leardilap/clasicOverdrive/README.md

# 3D view

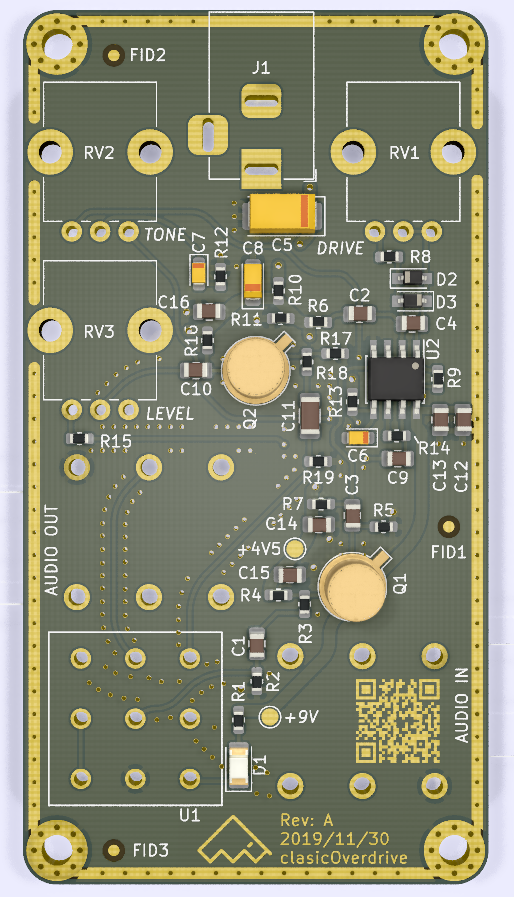
[picture p1: images/3D_top.png]
3D top


# Order Online

https://aisler.net/p/NZXUXPBU
