leardilap/clasicOverdrive/images/clasicOverdrive_QR.png

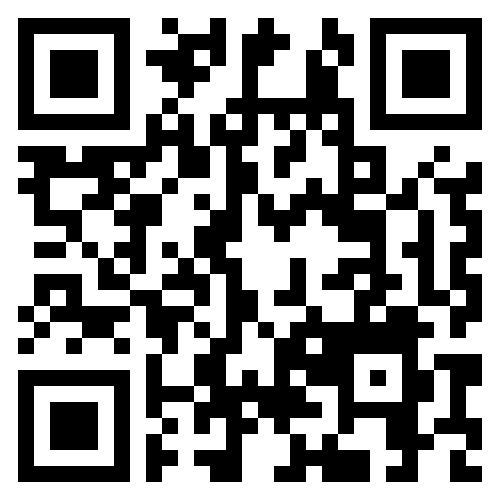
images/clasicOverdrive_QR.png
