leardilap/clasicOverdrive/pdf/clasicOverdrive.pdf

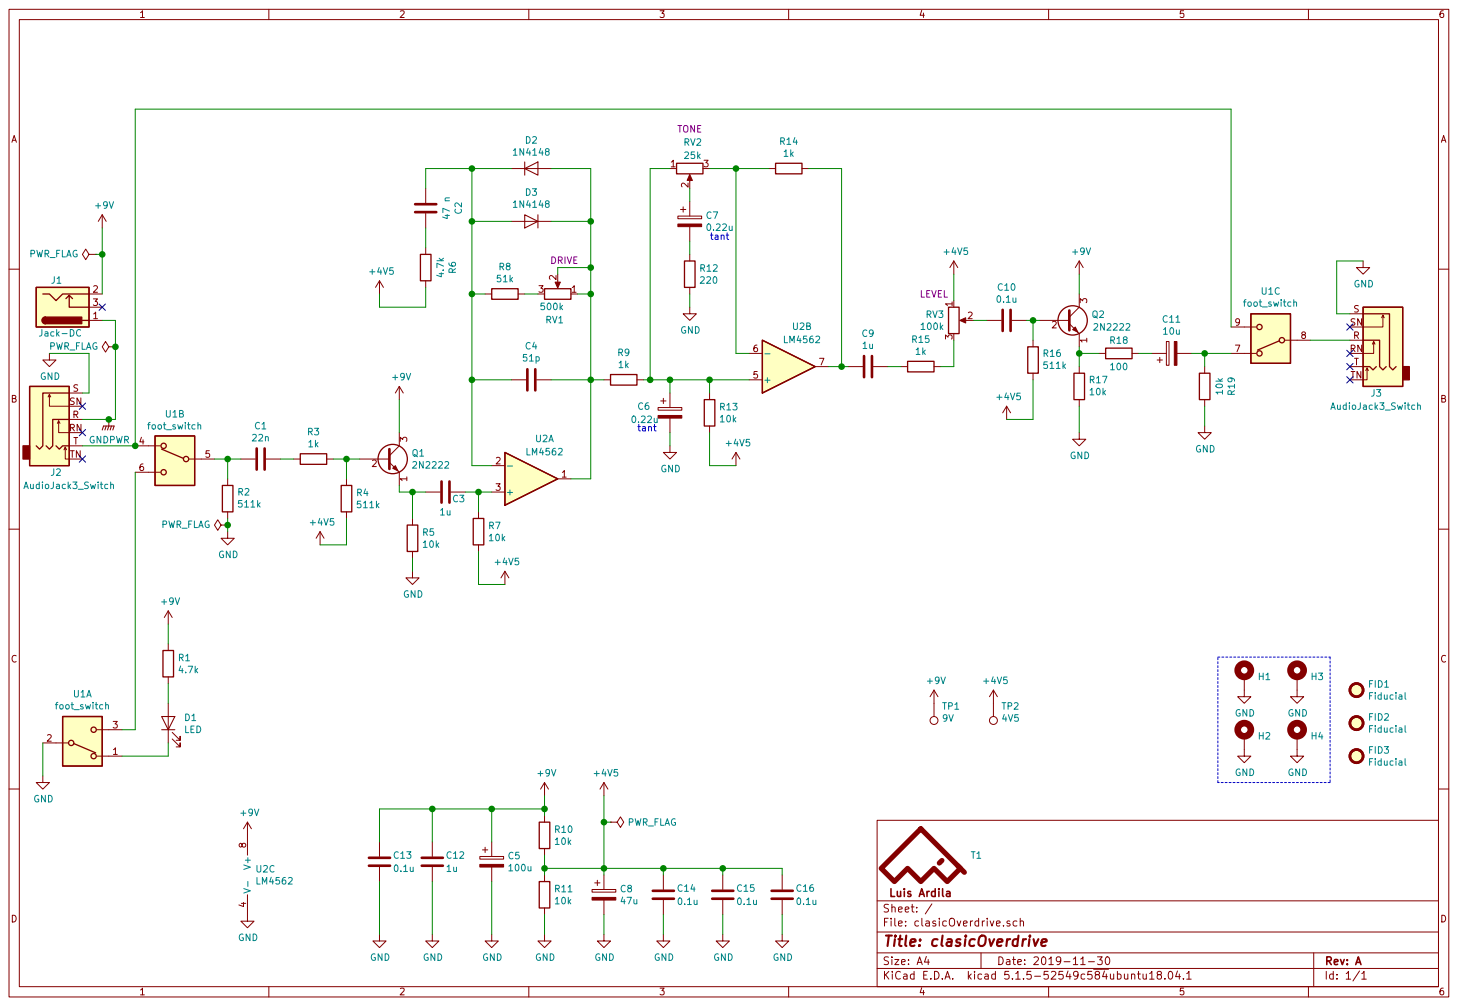
[picture p3: page 1]

Luis Ardila
File: clasicOverdrive.sch Sheet: /
Id: 1/1 Title: clasicOverdrive
