leardilap/clasicOverdrive/pdf/clasicOverdrive_pcb.pdf

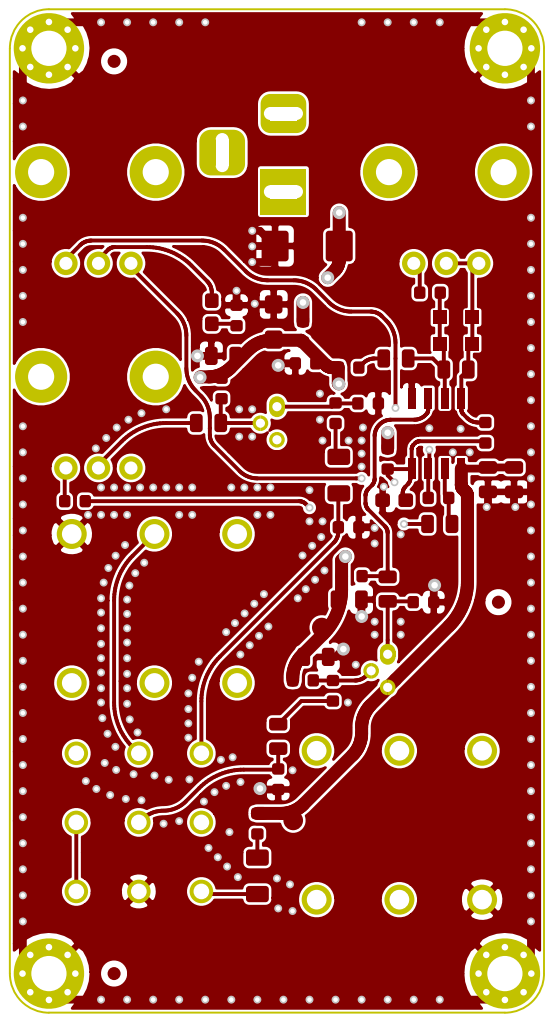
[picture p4: page 1]

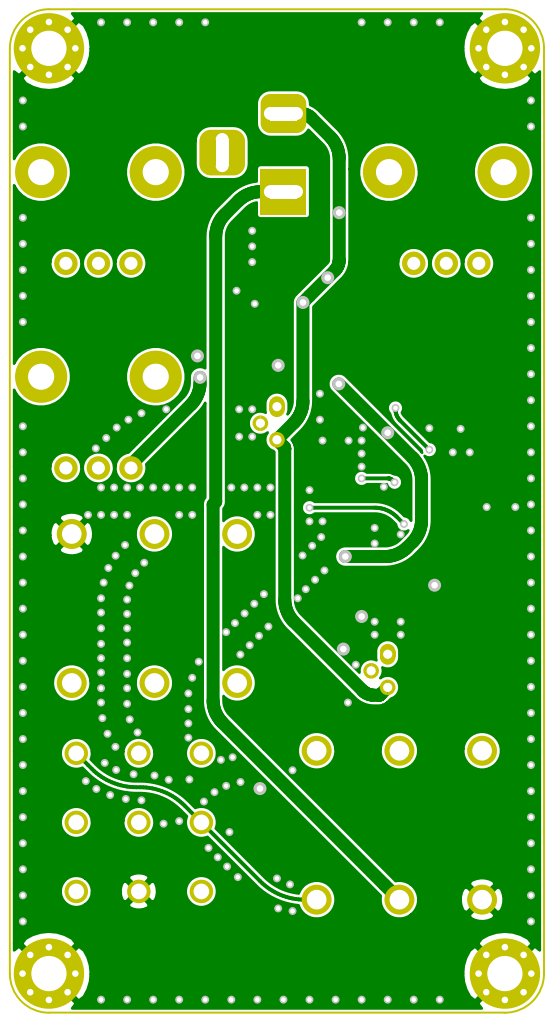
[picture p5: page 2]

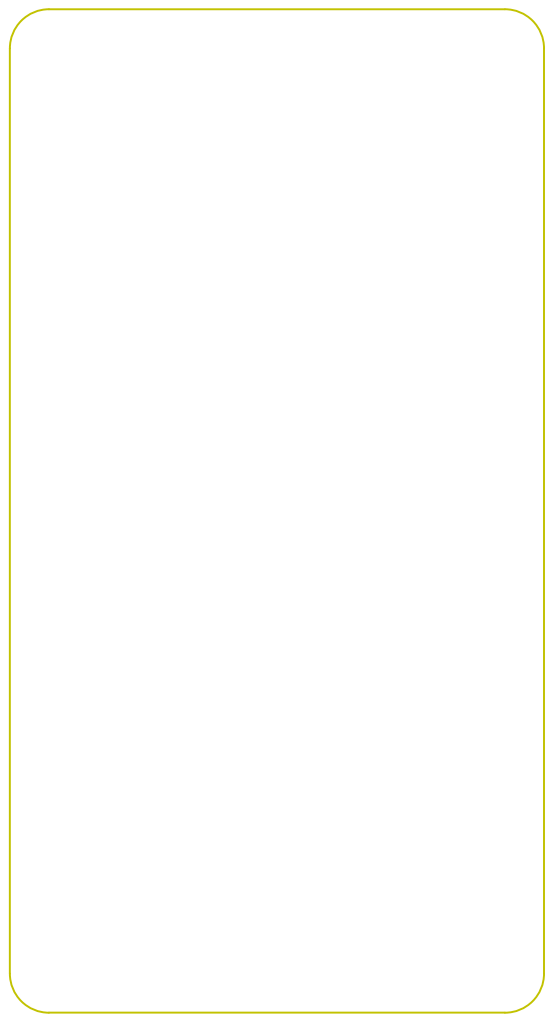
[picture p6: page 3]

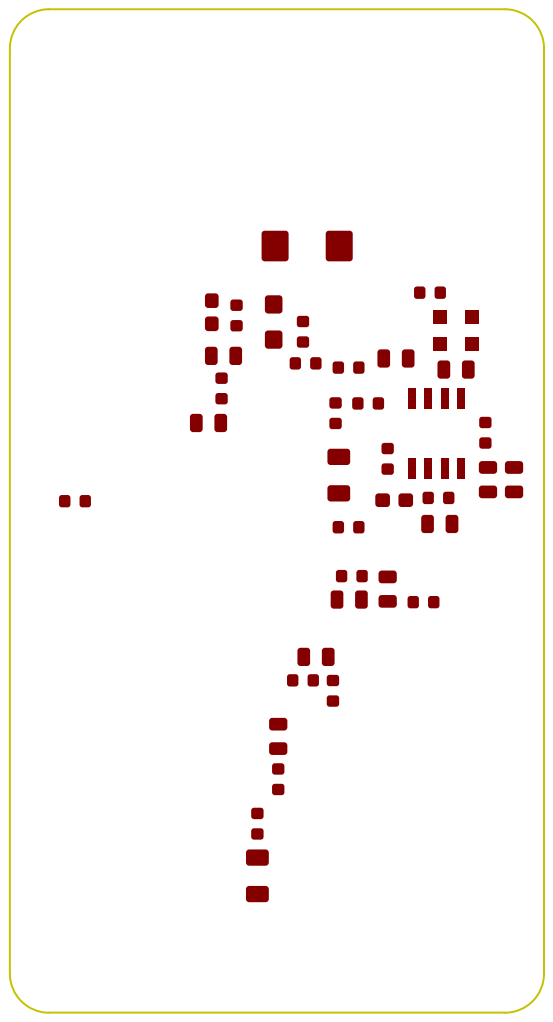
[picture p7: page 5]

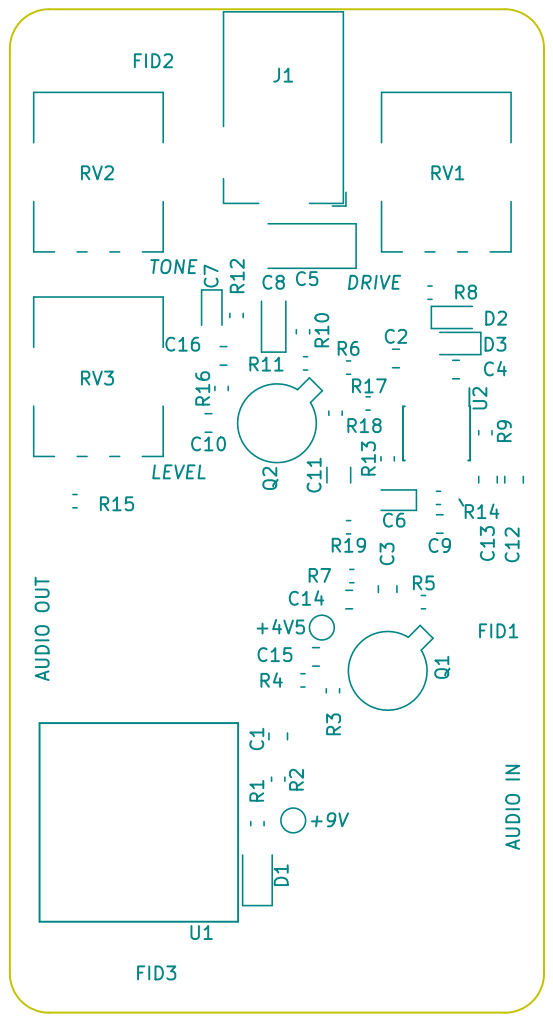
[picture p8: page 7]

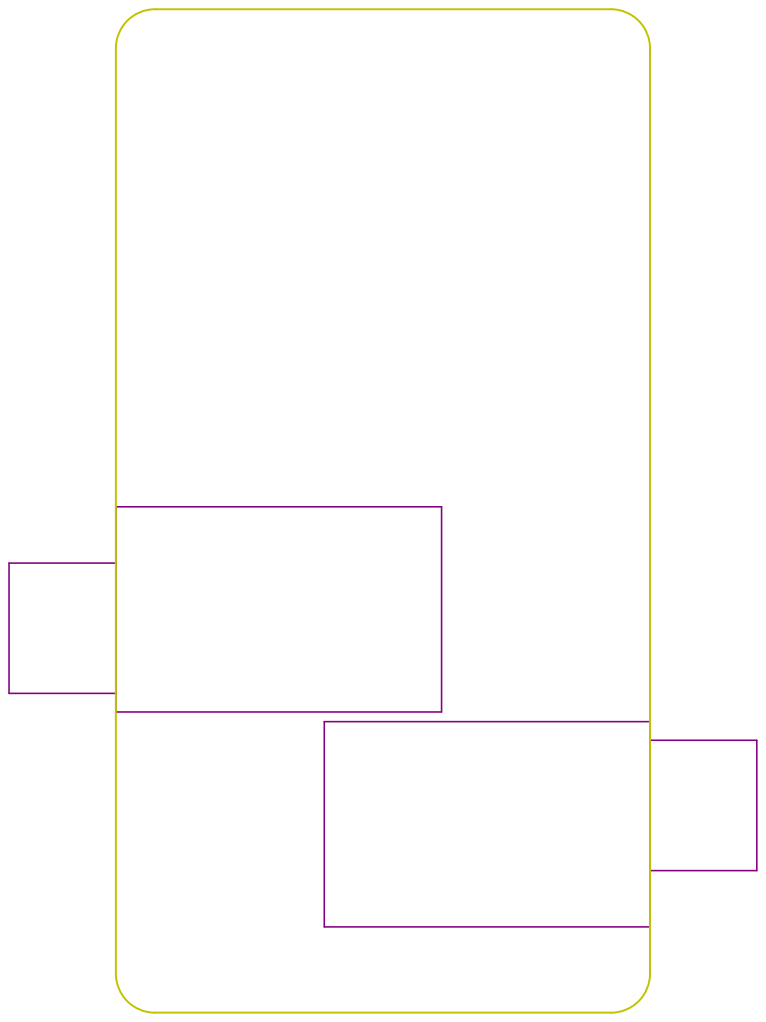
[picture p9: page 8]

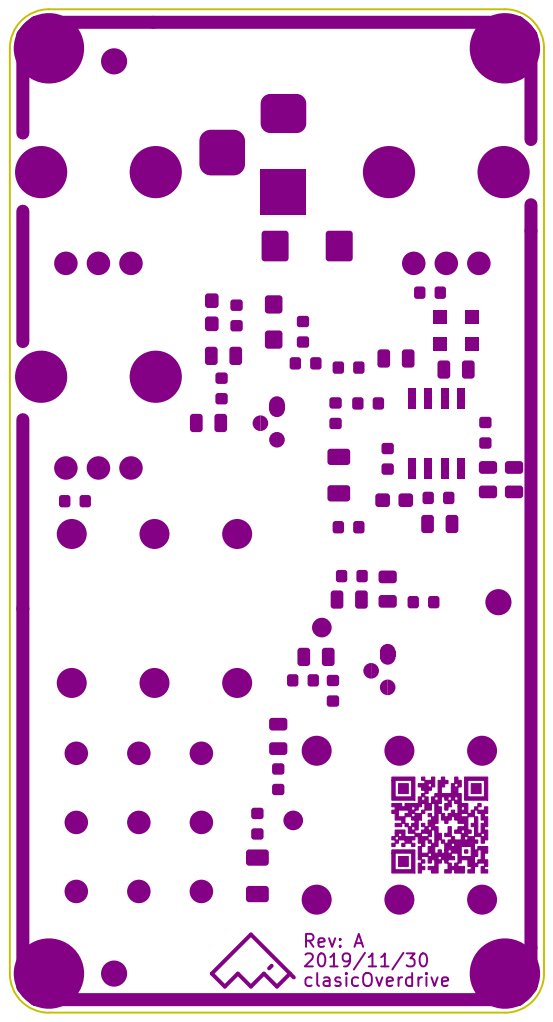
[picture p10: page 9]

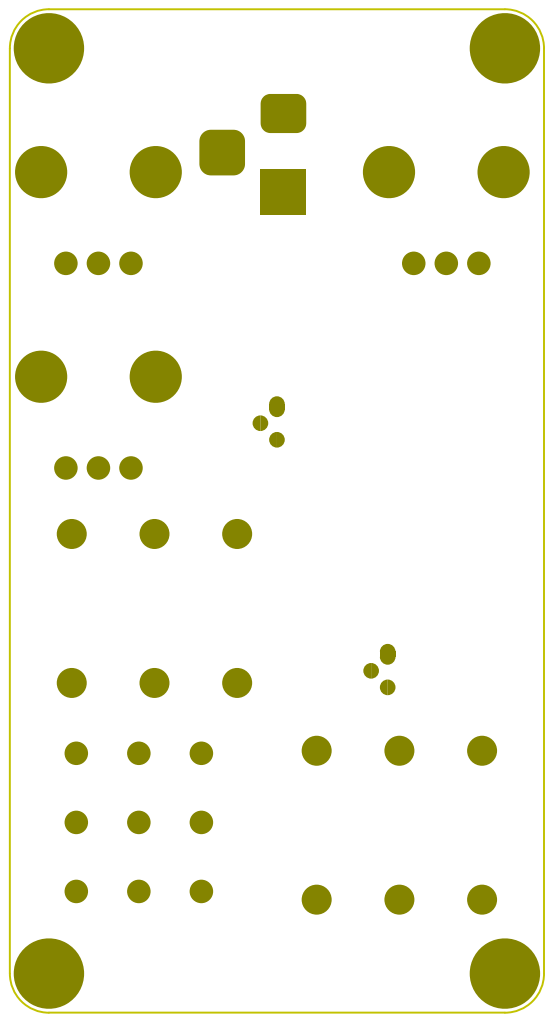
[picture p11: page 10]

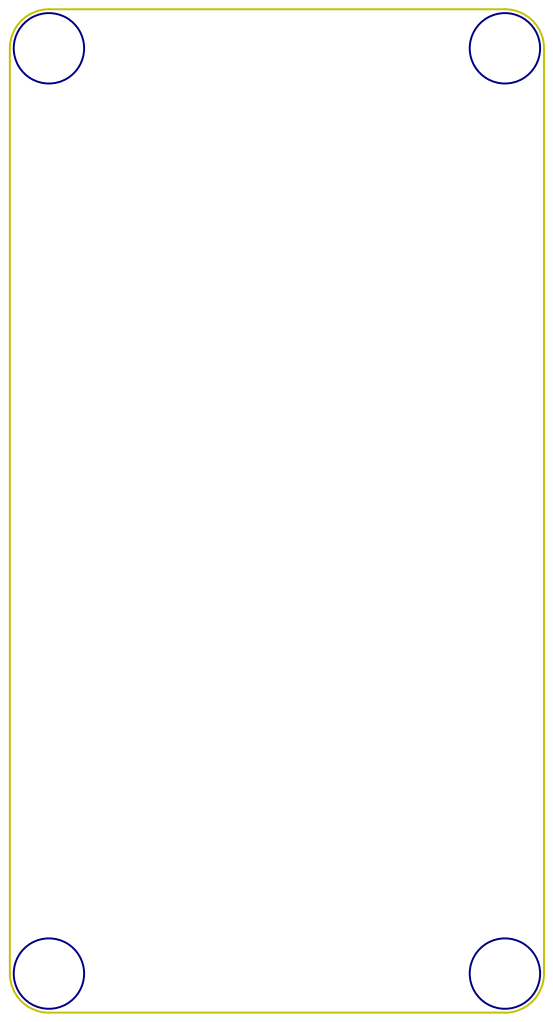
[picture p12: page 12]

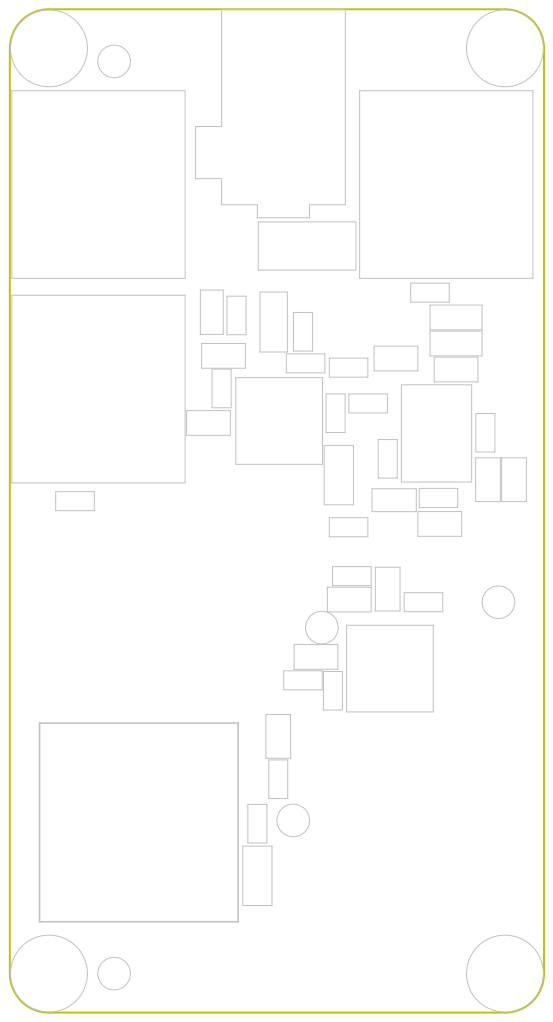
[picture p13: page 17]

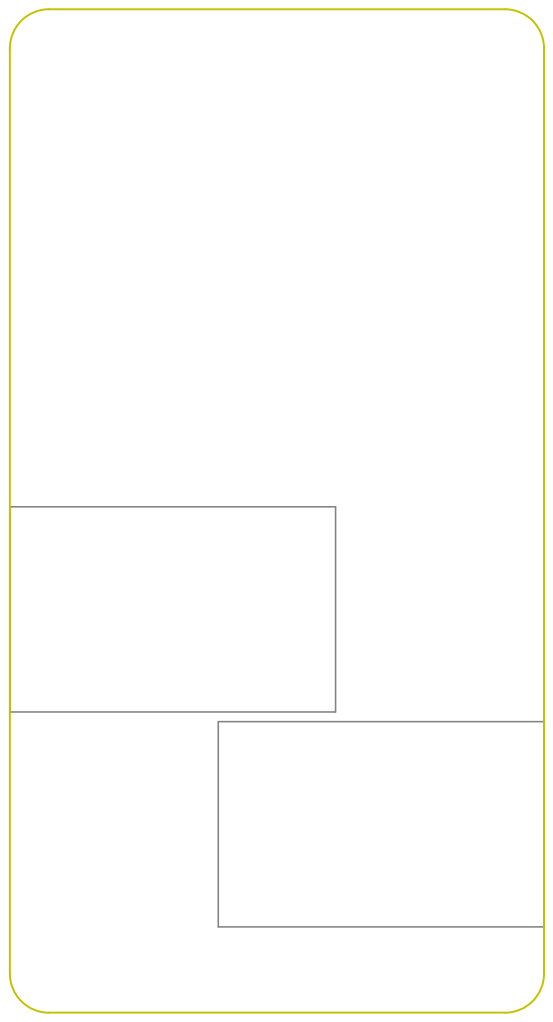
[picture p14: page 18]

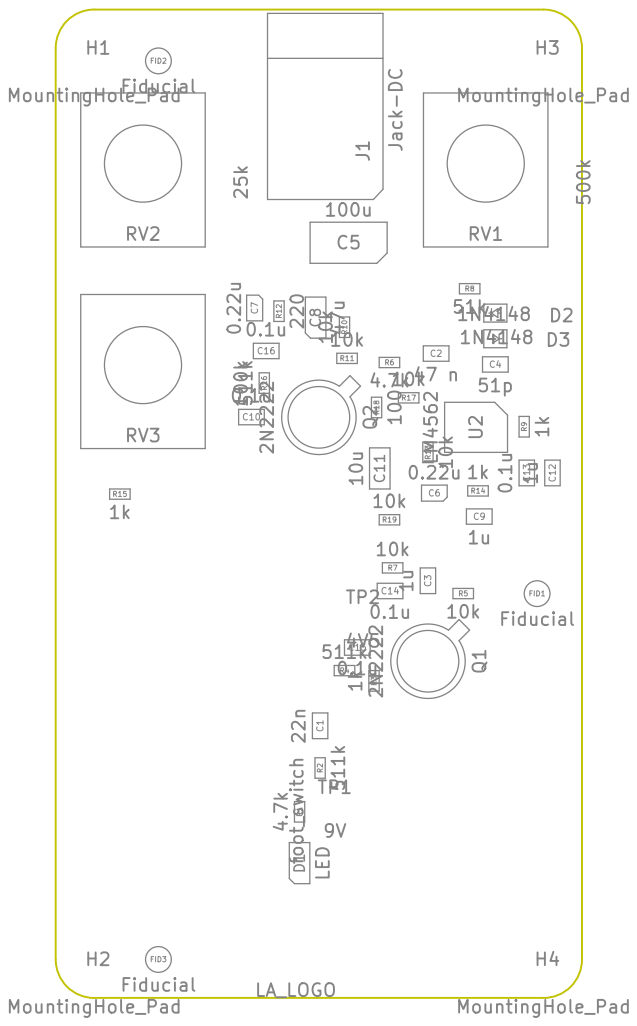
[picture p15: page 19]

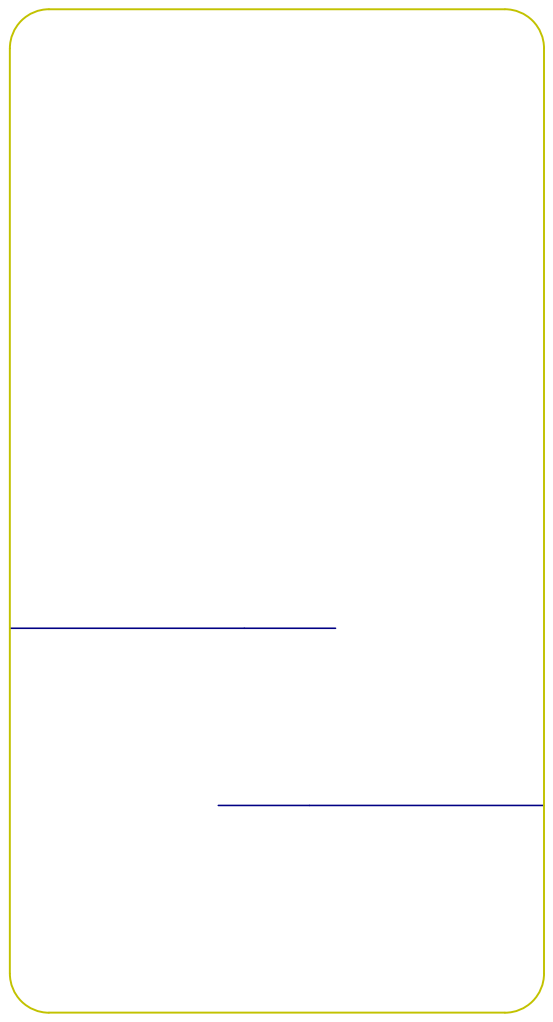
[picture p16: page 20]
