leardilap/clasicOverdrive/clasicOverdrive.kicad_pcb

## KiCad design clasicOverdrive.kicad_pcb (2019-12-09)

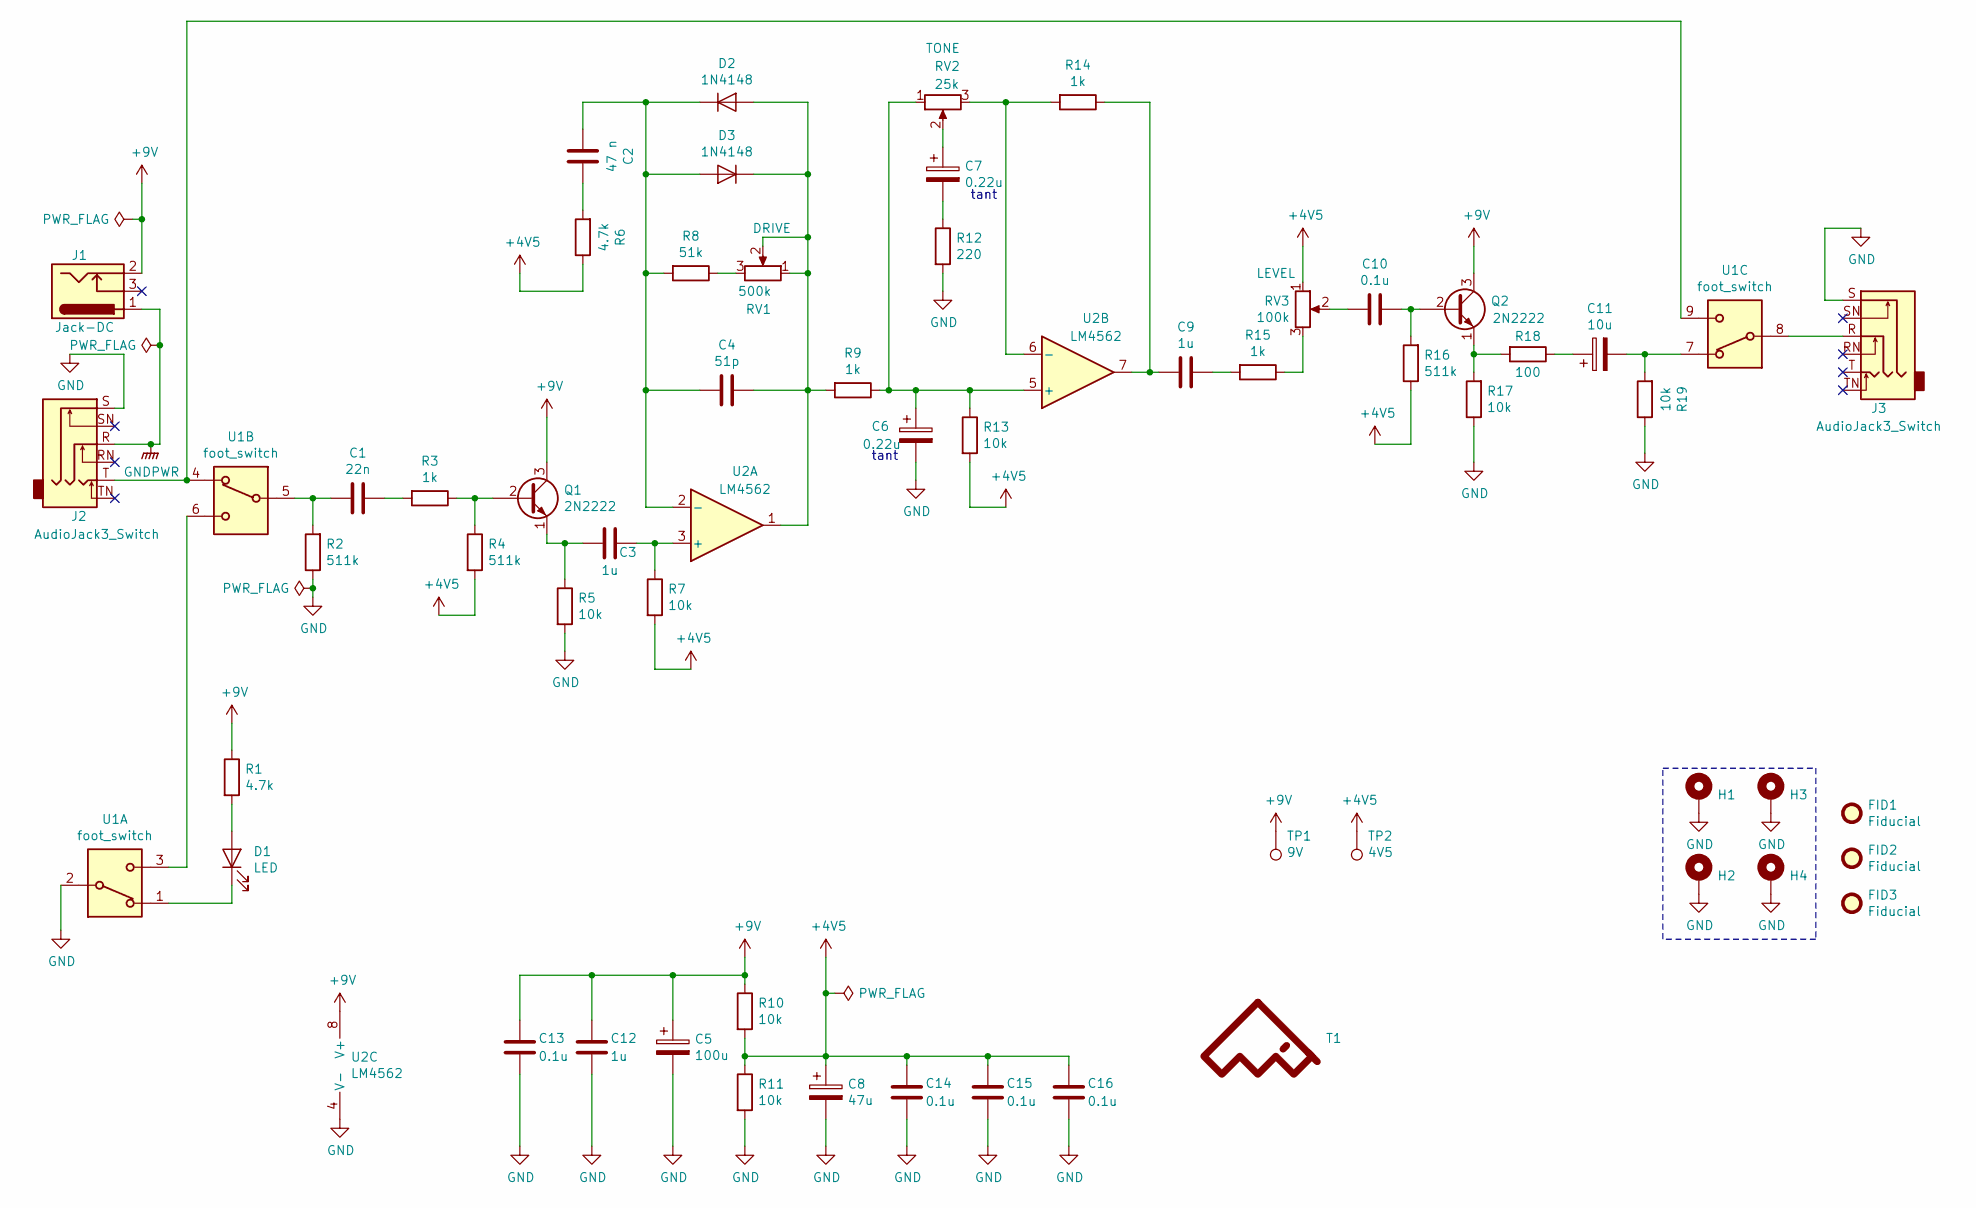
[picture p17: schematic clasicOverdrive.sch]

Parts:
C1: 22n; C_0805_2012Metric; Digi-Key 399-1163-1-ND
C2: 47 n; C_0805_2012Metric; Digi-Key 1276-2527-1-ND
C3, C9, C12: 1u; C_0805_2012Metric; Digi-Key 1276-6471-1-ND
C4: 51p; C_0805_2012Metric; Digi-Key 1276-2670-1-ND
C5: 100u; CP_EIA-6032-28_Kemet-C; Digi-Key 399-11392-1-ND
C6, C7: 0.22u; CP_EIA-2012-12_Kemet-R; Digi-Key 718-2502-1-ND
C8: 47u; CP_EIA-3216-18_Kemet-A; Digi-Key 718-2387-1-ND
C10, C13, C14, C15, C16: 0.1u; C_0805_2012Metric; Digi-Key 399-8000-1-ND
C11: 10u; C_1206_3216Metric; Digi-Key 478-10743-1-ND
D1: LED; LED_1206_3216Metric; Digi-Key 732-4989-1-ND
D2, D3: 1N4148; D_SOD-323_HandSoldering; Digi-Key 1N4148WXTPMSCT-ND
FID1, FID2, FID3: Fiducial; Fiducial_1mm_Mask2mm
H1, H2, H3, H4: MountingHole_Pad; MountingHole_2.7mm_M2.5_Pad_Via
J1: Jack-DC; BarrelJack_Horizontal; Digi-Key CP-002A-ND
J2, J3: AudioJack3_Switch; Jack_6.35mm_Amphenol_ACJS-MHOM; Digi-Key 889-1818-ND
Q1, Q2: 2N2222; TO-18-3; Digi-Key 1514-2N2222APBFREE-ND
R1, R6: 4.7k; R_0603_1608Metric; Digi-Key 311-4.70KHRCT-ND
R2, R4, R16: 511k; R_0603_1608Metric; Digi-Key 311-511KHRCT-ND
R3, R9, R14, R15: 1k; R_0603_1608Metric; Digi-Key 311-1.00KHRCT-ND
R5, R7, R10, R11, R13, R17, R19: 10k; R_0603_1608Metric; Digi-Key 311-10.0KHRCT-ND
R8: 51k; R_0603_1608Metric; Digi-Key YAG3616CT-ND
R12: 220; R_0603_1608Metric; Digi-Key 311-220HRCT-ND
R18: 100; R_0603_1608Metric; Digi-Key 311-100HRCT-ND
RV1: 500k; Potentiometer_Bourns_PTV09A-1_Single_Vertical; Digi-Key PTV09A-4020F-A504-ND
RV2: 25k; Potentiometer_Bourns_PTV09A-1_Single_Vertical; Digi-Key PTV09A-4020F-B203-ND
RV3: 100k; Potentiometer_Bourns_PTV09A-1_Single_Vertical; Digi-Key PTV09A-4020F-B104-ND
T1: LA_LOGO; LA_LOGO_MASK
TP1: 9V; TestPoint_Pad_D1.5mm
TP2: 4V5; TestPoint_Pad_D1.5mm
U1: foot_switch; Foot_Switch_E-Switch_FS57003PLT2B2M2QE; Digi-Key EG5492-ND
U2: LM4562; SOIC-8_3.9x4.9mm_P1.27mm; Digi-Key 296-35279-1-ND

Connections:
+4V5: C8.1, C14.1, C15.1, C16.1, R4.2, R6.1, R7.2, R10.2, R11.1, R13.2, R16.1, RV3.1, TP2.1
+9V: C5.1, C12.1, C13.1, J1.2, Q1.3 (C), Q2.3 (C), R1.1, R10.1, TP1.1, U2.8 (V+)
GND: C5.2, C6.2, C8.2, C12.2, C13.2, C14.2, C15.2, C16.2, H1.1, H2.1, H3.1, H4.1, J2.S, J3.S, R2.1, R5.2, R11.2, R12.2, R17.1, R19.1, U1.2, U2.4 (V-)
GNDPWR: J1.1, J2.R
unnamed: C1.1, R3.2
unnamed: C1.2, R2.2, U1.5
unnamed: C2.1, R6.2
unnamed: C2.2, C4.1, D2.1 (K), D3.2 (A), R8.2, U2.2 (-)
unnamed: C3.1, R7.1, U2.3 (+)
unnamed: C3.2, Q1.1 (E), R5.1
unnamed: C4.2, D2.2 (A), D3.1 (K), R9.2, RV1.1, RV1.2, U2.1
unnamed: C6.1, R9.1, R13.1, RV2.1, U2.5 (+)
unnamed: C7.1, RV2.2
unnamed: C7.2, R12.1
unnamed: C9.1, R15.2
unnamed: C9.2, R14.1, U2.7
unnamed: C10.1, Q2.2 (B), R16.2
unnamed: C10.2, RV3.2
unnamed: C11.1, R18.1
unnamed: C11.2, R19.2, U1.7
unnamed: D1.1 (K), U1.1
unnamed: D1.2 (A), R1.2
unnamed: J2.T, U1.4, U1.9
unnamed: J3.R, U1.8
unnamed: Q1.2 (B), R3.1, R4.1
unnamed: Q2.1 (E), R17.2, R18.2
unnamed: R8.1, RV1.3
unnamed: R14.2, RV2.3, U2.6 (-)
unnamed: R15.1, RV3.3
unnamed: U1.3, U1.6

Notes on the sheet:
tant

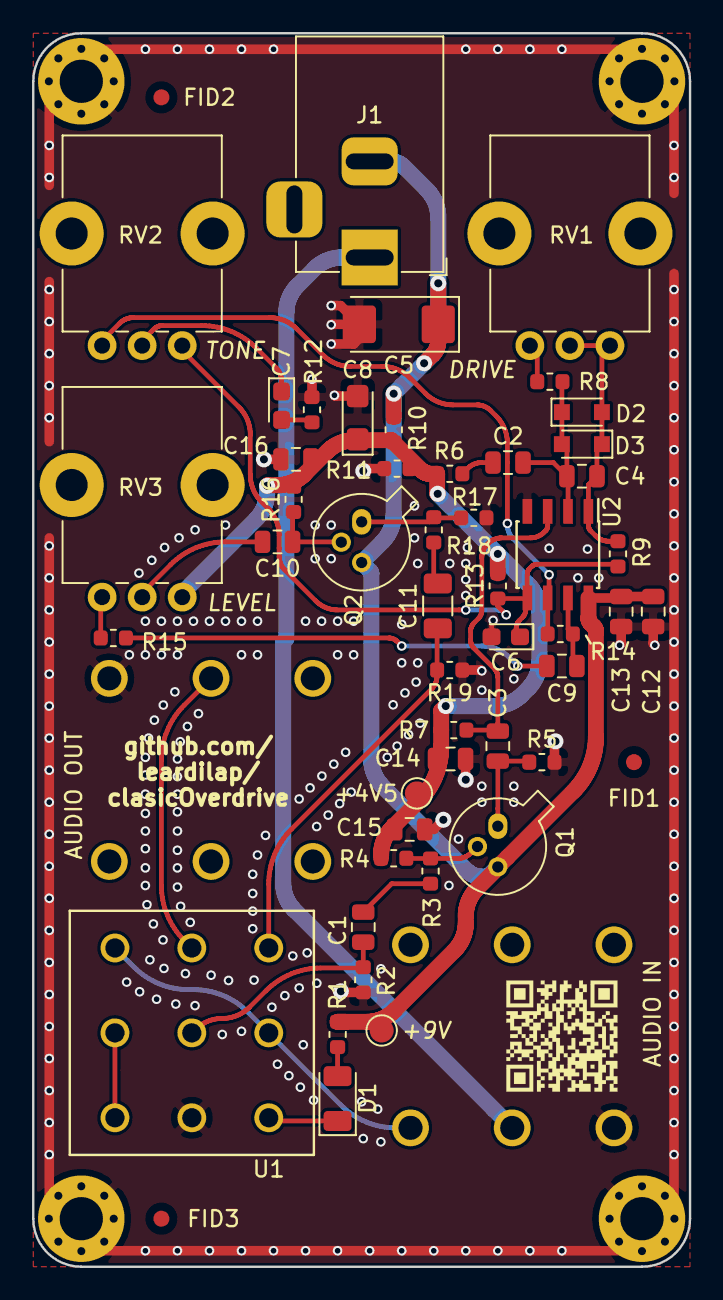
[picture p18: board clasicOverdrive.kicad_pcb from above]

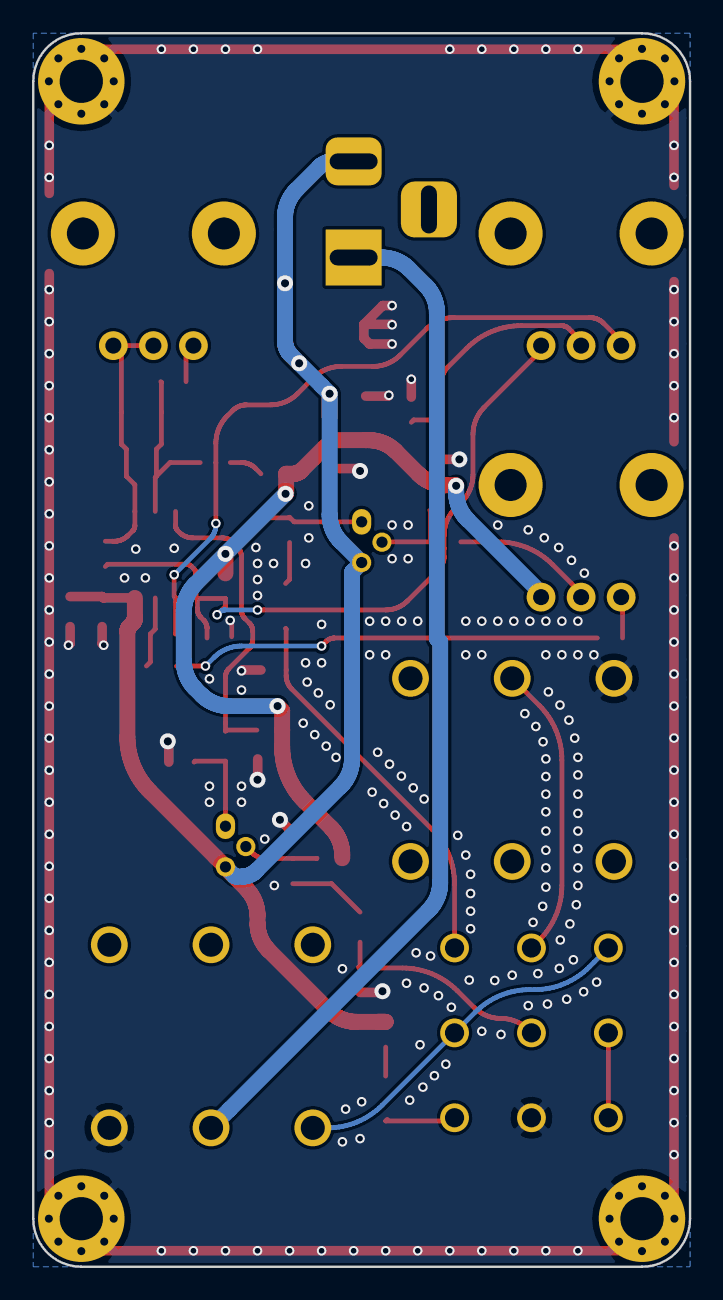
[picture p19: board clasicOverdrive.kicad_pcb from below]

Board: 2 copper layers, 41.0 x 77.0 mm, 58 parts (2 on the bottom side), 30 nets.
