leardilap/clasicOverdrive/(commit log)

2018-04-11 schematic finished
    [clasicOverdrive.kicad_pcb, clasicOverdrive.sch]
2018-04-11 annotate and footprint assignment init
    [clasicOverdrive.kicad_pcb, clasicOverdrive.sch]
2018-04-12 all footprints added and layout of pcb complete
    [clasicOverdrive.kicad_pcb, clasicOverdrive.sch]
2018-04-15 after freeRouter run
    [clasicOverdrive.dsn, clasicOverdrive.kicad_pcb]
2018-04-21 Board Finished
    [clasicOverdrive.dsn, clasicOverdrive.kicad_pcb, clasicOverdrive.sch]
2018-08-08 updated bom and footprint for the diodes@
    [clasicOverdrive.csv, clasicOverdrive.kicad_pcb, clasicOverdrive.sch]
2018-11-07 update pcb and schematic with pads
    [clasicOverdrive-B.Cu.gbr, clasicOverdrive-B.Mask.gbr, clasicOverdrive-B.Paste.gbr, clasicOverdrive-B.SilkS.gbr, clasicOverdrive-Edge.Cuts.gbr, clasicOverdrive-F.Cu.gbr, clasicOverdrive-F.Mask.gbr, clasicOverdrive-F.Paste.gbr]
2019-01-17 3D updated of transistors
    [clasicOverdrive.kicad_pcb]
2019-11-30 Rev A
    [clasicOverdrive-B.Cu.gbr, clasicOverdrive-B.Mask.gbr, clasicOverdrive-B.Paste.gbr, clasicOverdrive-B.SilkS.gbr, clasicOverdrive-B_Cu.gbr, clasicOverdrive-Edge.Cuts.gbr, clasicOverdrive-Edge_Cuts.gbr, clasicOverdrive-F.Cu.gbr]
2019-11-30 cache of footprints
    [clasicOverdrive.kicad_pcb]
2019-11-30 Gerbers Rev A
2019-11-30 Rev A fix silkscreen and test points names
    [clasicOverdrive-B_Cu.gbr, clasicOverdrive-Edge_Cuts.gbr, clasicOverdrive-F_Cu.gbr, clasicOverdrive-F_Mask.gbr, clasicOverdrive-F_Paste.gbr, clasicOverdrive-F_SilkS.gbr, clasicOverdrive-NPTH-drl.gbr, clasicOverdrive-PTH-drl.gbr]
2019-11-30 Rev A: include mask of bottom
    [clasicOverdrive-B_Cu.gbr, clasicOverdrive-B_Mask.gbr, clasicOverdrive-B_Paste.gbr, clasicOverdrive-B_SilkS.gbr, clasicOverdrive-Edge_Cuts.gbr, clasicOverdrive-F_Cu.gbr, clasicOverdrive-F_Mask.gbr, clasicOverdrive-F_Paste.gbr]
2019-12-01 Rev A: Submitted
    [Digi-Key_2019-11-30T175804.csv]
2019-12-01 Rev-A Fabricated 2019_12_01
    [clasicOverdrive-B_Cu.gbr, clasicOverdrive-B_Mask.gbr, clasicOverdrive-B_Paste.gbr, clasicOverdrive-B_SilkS.gbr, clasicOverdrive-Edge_Cuts.gbr, clasicOverdrive-F_Cu.gbr, clasicOverdrive-F_Mask.gbr, clasicOverdrive-F_Paste.gbr]
2019-12-09 Rev A - fabrication 2: silkscreen QR and website
    [clasicOverdrive-B_Cu.gbr, clasicOverdrive-B_Mask.gbr, clasicOverdrive-B_Paste.gbr, clasicOverdrive-Edge_Cuts.gbr, clasicOverdrive-F_Cu.gbr, clasicOverdrive-F_Mask.gbr, clasicOverdrive-F_Paste.gbr, clasicOverdrive-F_SilkS.gbr]
